norberts1/hometop_ht_transceiver/hw/pitiny/HT_pitiny_montiert.png

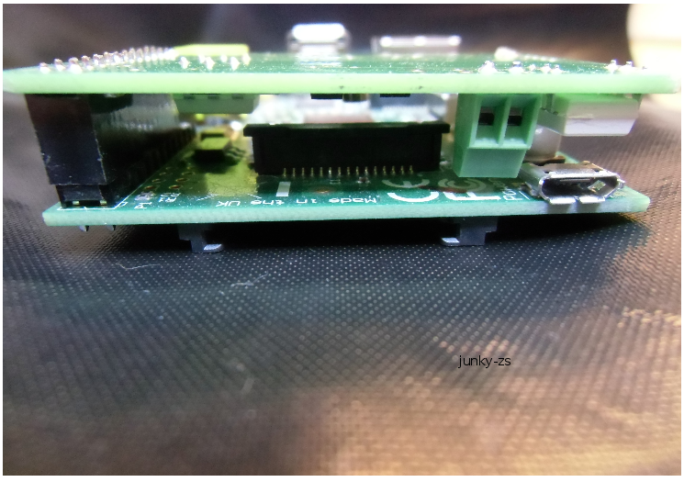
hw/pitiny/HT_pitiny_montiert.png
