norberts1/hometop_ht_transceiver/hw/piduino/piduino_adapter_komplett.png

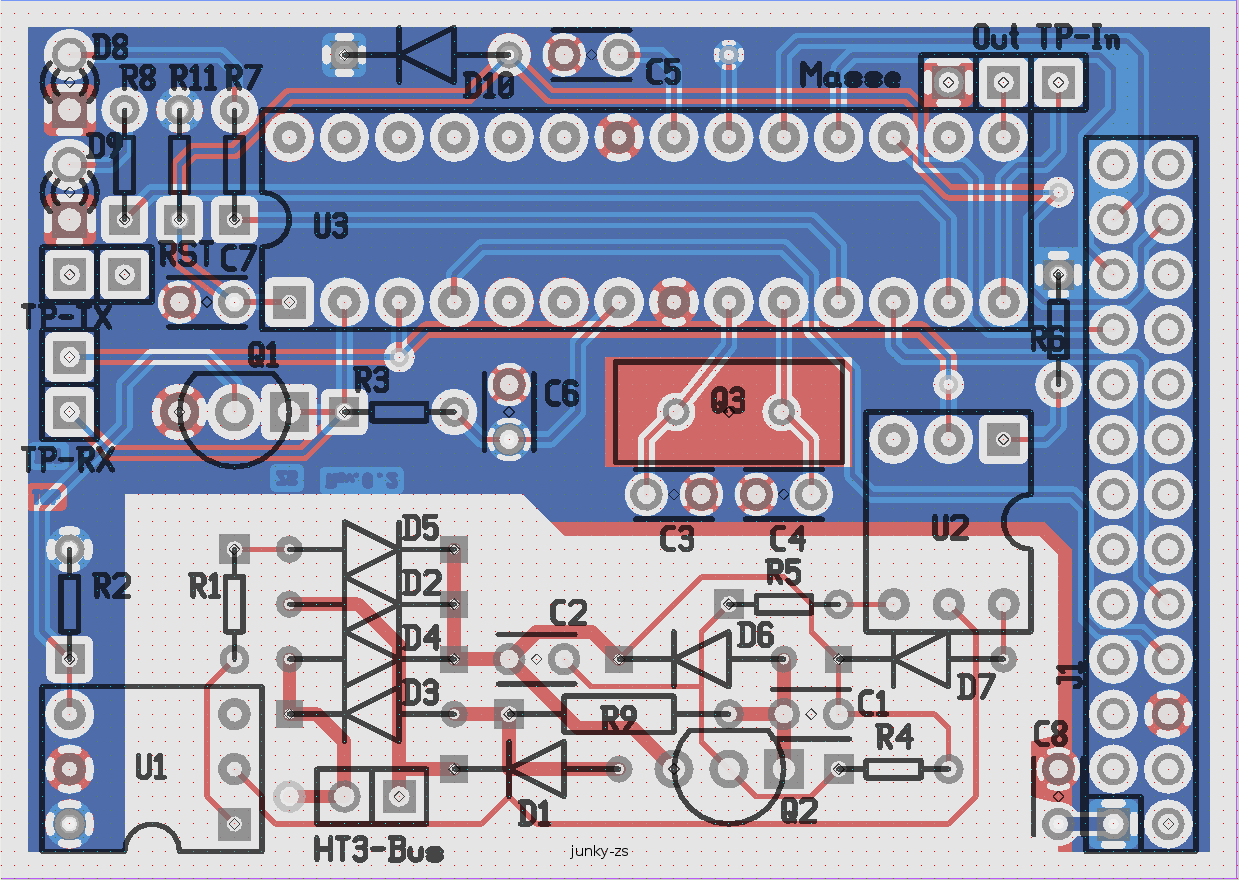
hw/piduino/piduino_adapter_komplett.png
