norberts1/hometop_ht_transceiver/hw/piduino/Raspi_HT_piduino_Schaltplan.png

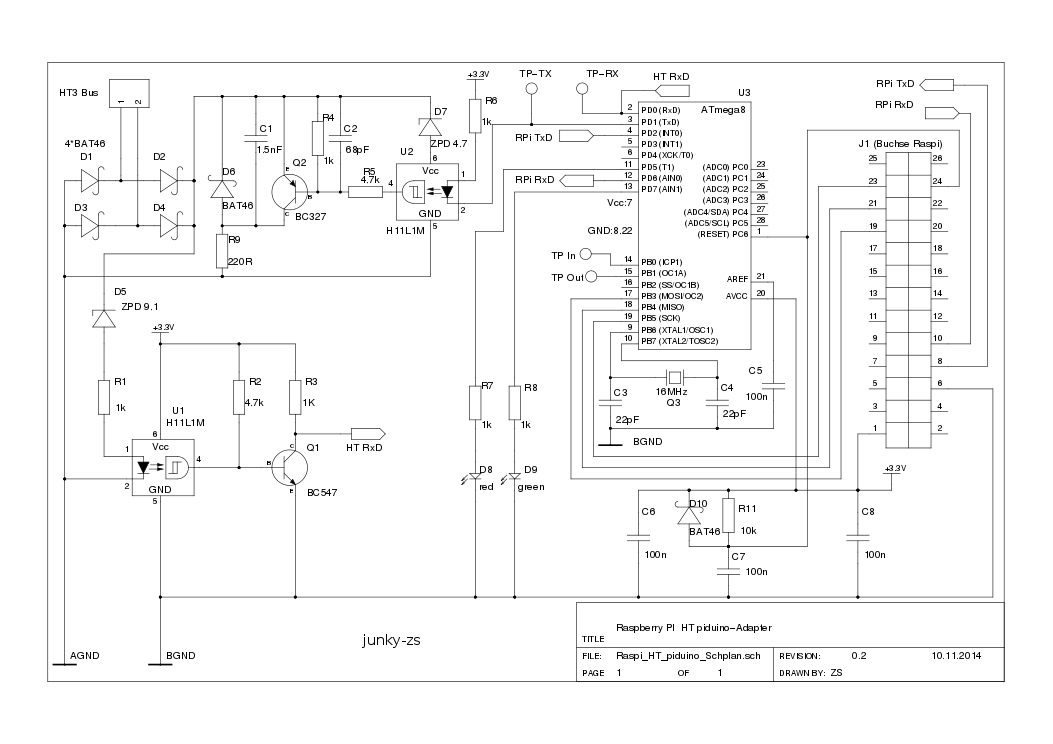
hw/piduino/Raspi_HT_piduino_Schaltplan.png
