norberts1/hometop_ht_transceiver/hw/pitiny/Raspi_HT_pitiny_Schaltplan.png

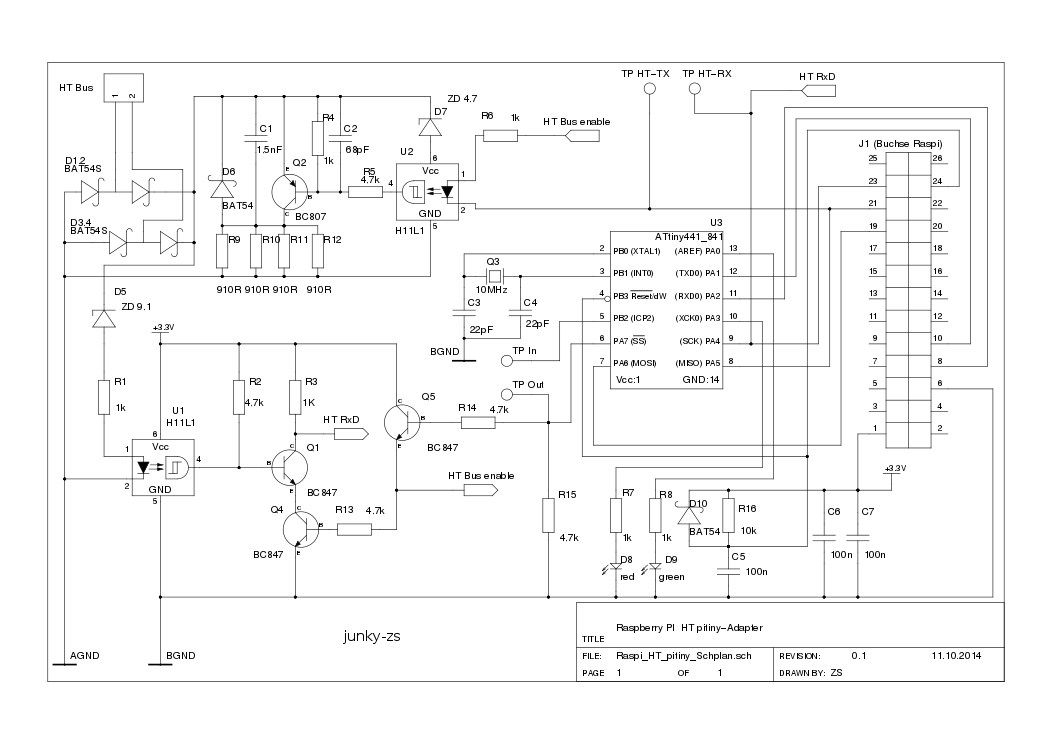
hw/pitiny/Raspi_HT_pitiny_Schaltplan.png
