norberts1/hometop_ht_transceiver/(list of files, drawings)

Other design files:
hw/piduino/Raspi_HT_piduino_PCB.pcb
hw/pitiny/Raspi_HT_pitiny_PCB.pcb
