norberts1/hometop_ht_transceiver/(commit log)

2014-12-15 ht_transceiver initial release
    [fuses.ods]
2014-12-16 BOM added for ht_piduino and ht_pitiny
    [Stueckliste_HT_piduino_Adapter_distrelec.csv, Stueckliste_HT_pitiny_Adapter_distrelec.csv]
2015-03-21 BOD bits set
    [fuses.ods]
2015-10-15 PCB-layout and circuit-diagram added
    [Raspi_HT_piduino_PCB.pcb, Raspi_HT_piduino_Schaltplan.sch]
2016-01-09 script added for ht_pitiny-board preparation
2016-04-11 gerberfiles added
2016-04-11 pitiny gerberfiles added
2016-06-21 gerber rev. 0.2 added
2016-06-21 BOM reference added
    [Stueckliste_HT_piduino_Adapter_distrelec.csv]
